IowaDave/power-down-sleep-for-a-year/images/figure_4.jpg

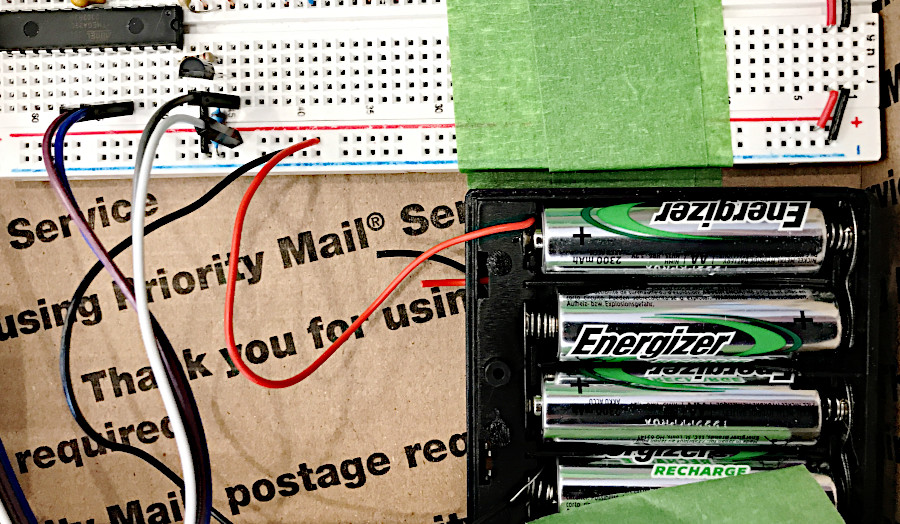
images/figure_4.jpg
