IowaDave/power-down-sleep-for-a-year/images/figure_5.jpg

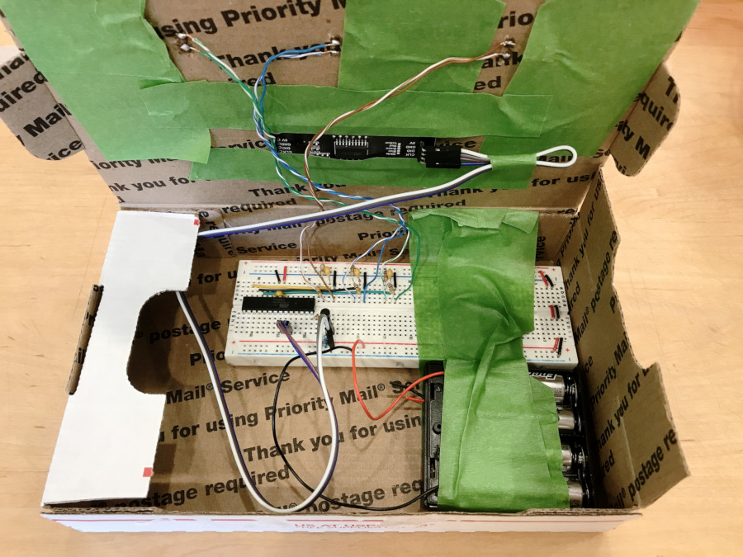
images/figure_5.jpg
