IowaDave/power-down-sleep-for-a-year/(commit log)

2024-12-09 Landing message
2024-12-11 rearrange text for better flow
