IowaDave/power-down-sleep-for-a-year/(notices)

Notices in the files:
example/Tea-Timer_14Jan2024/Tea-Timer_14Jan2024.ino:
Public License along with this library; if not, write to the
Free Software Foundation, Inc., 59 Temple Place, Suite 330,
Boston, MA 02111-1307 USA
